lukeweston/LaserCutter/README.markdown

Open-hardware Arduino-compatible (Arduino Mega 2650-compatible) CNC laser cutter

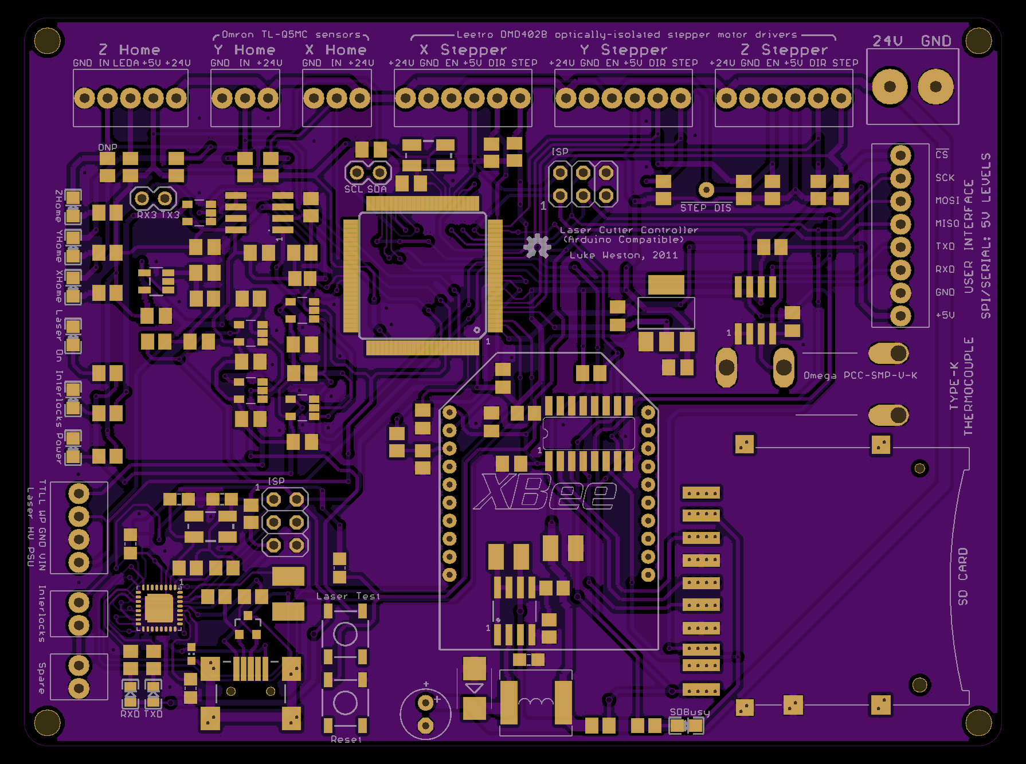
[picture p1: LaserCutter-pcb.png]


Documentation goes here - when it's done.
