lukeweston/LaserCutter/LaserCutter-schematic.png

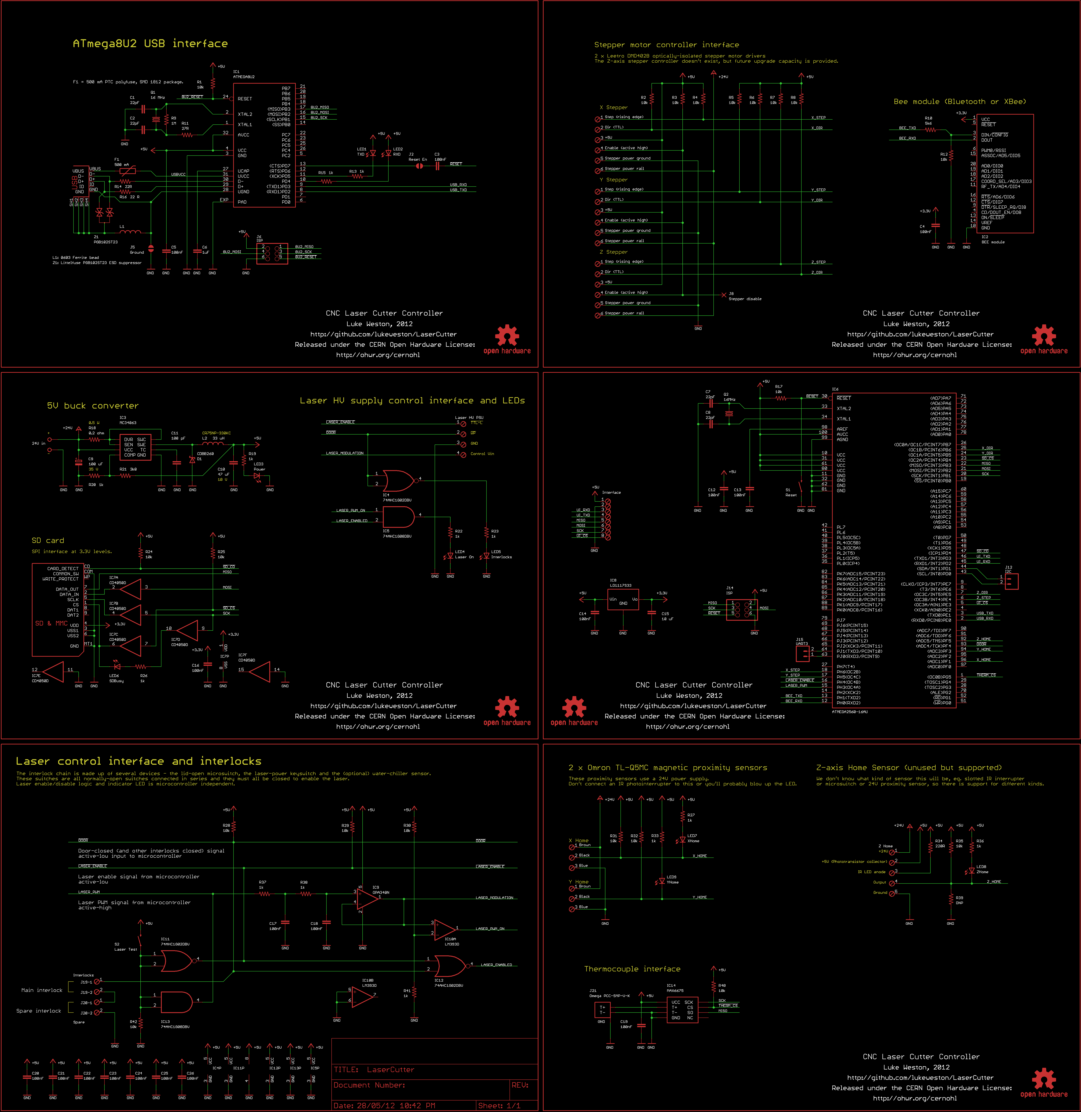
LaserCutter-schematic.png
