lukeweston/LaserCutter/LaserCutter.brd

## EAGLE design LaserCutter.brd (2012-07-18)

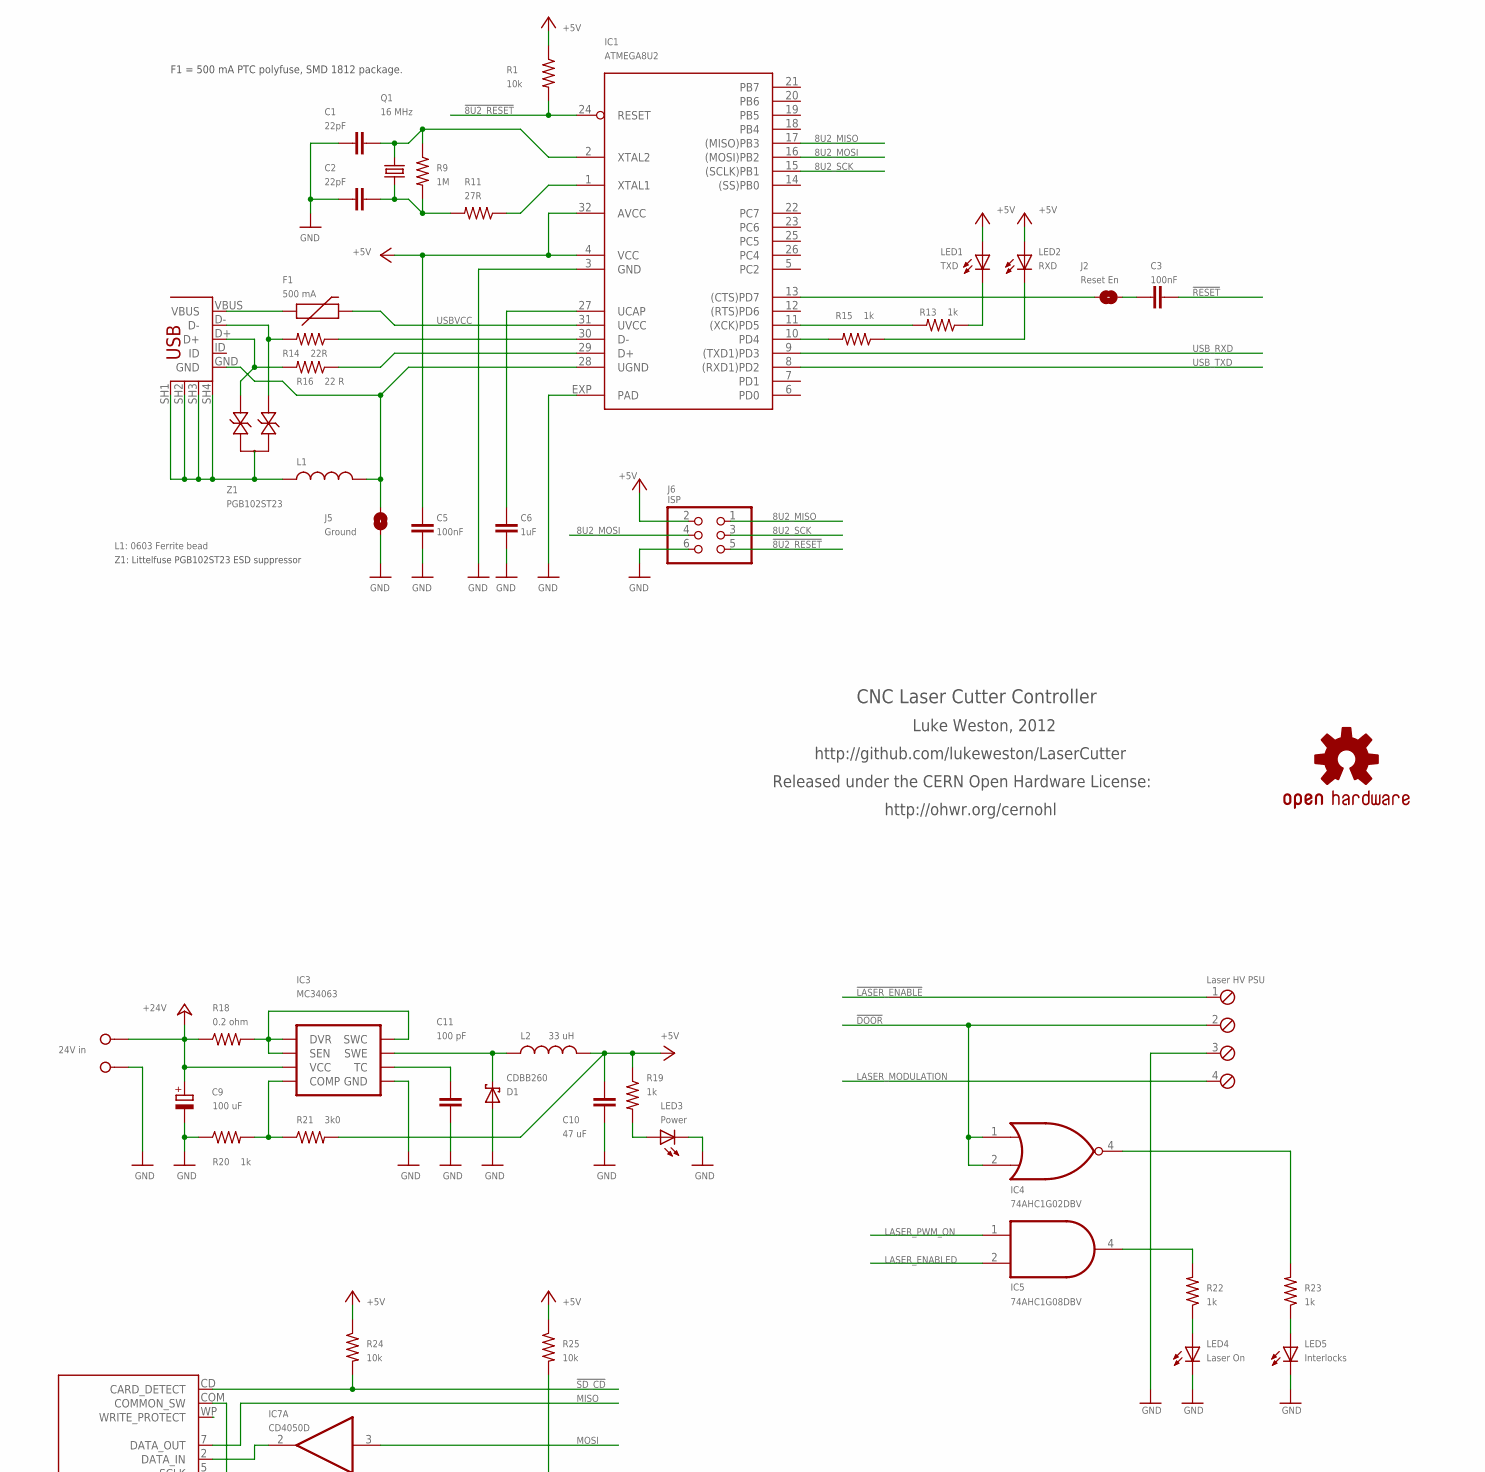
[picture p3: schematic LaserCutter.sch, part in row 1, column 1]

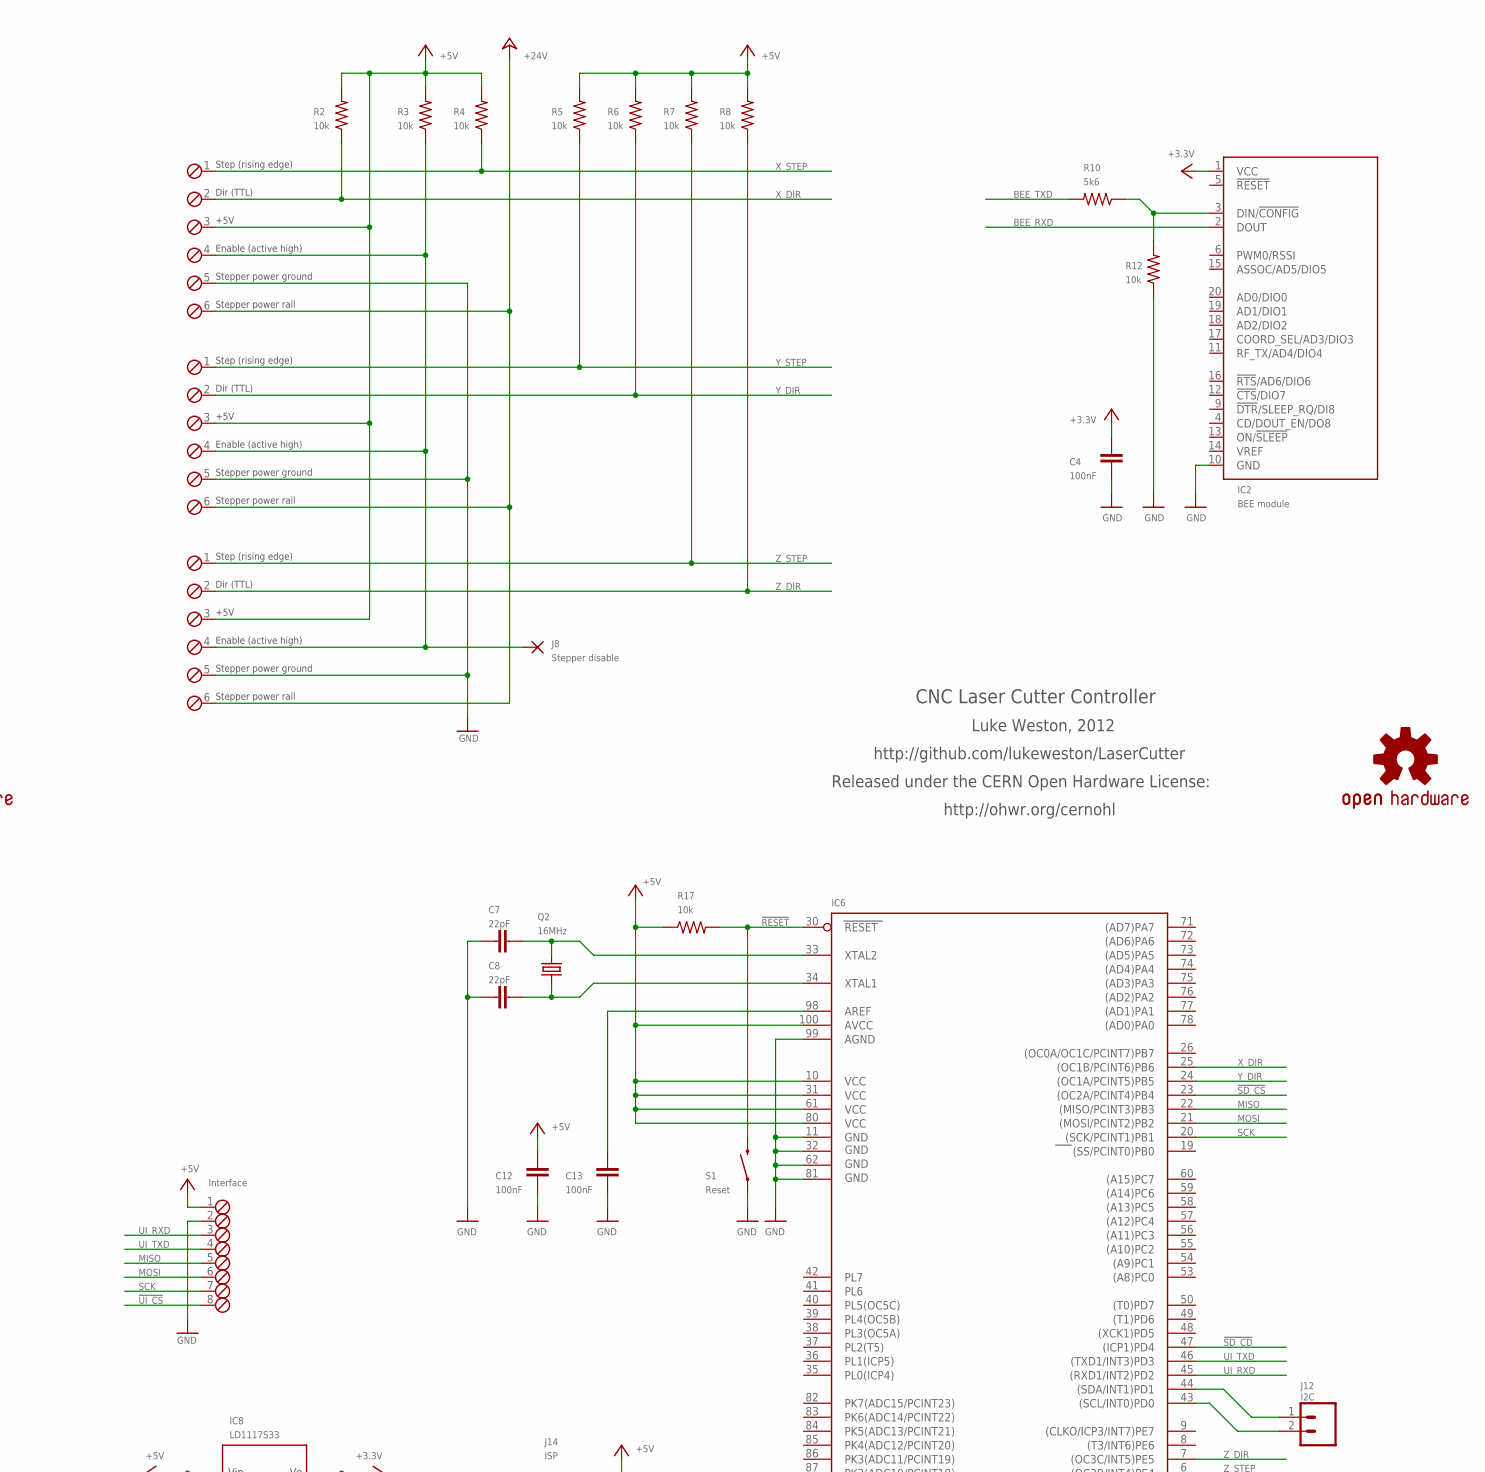
[picture p4: schematic LaserCutter.sch, part in row 1, column 2]

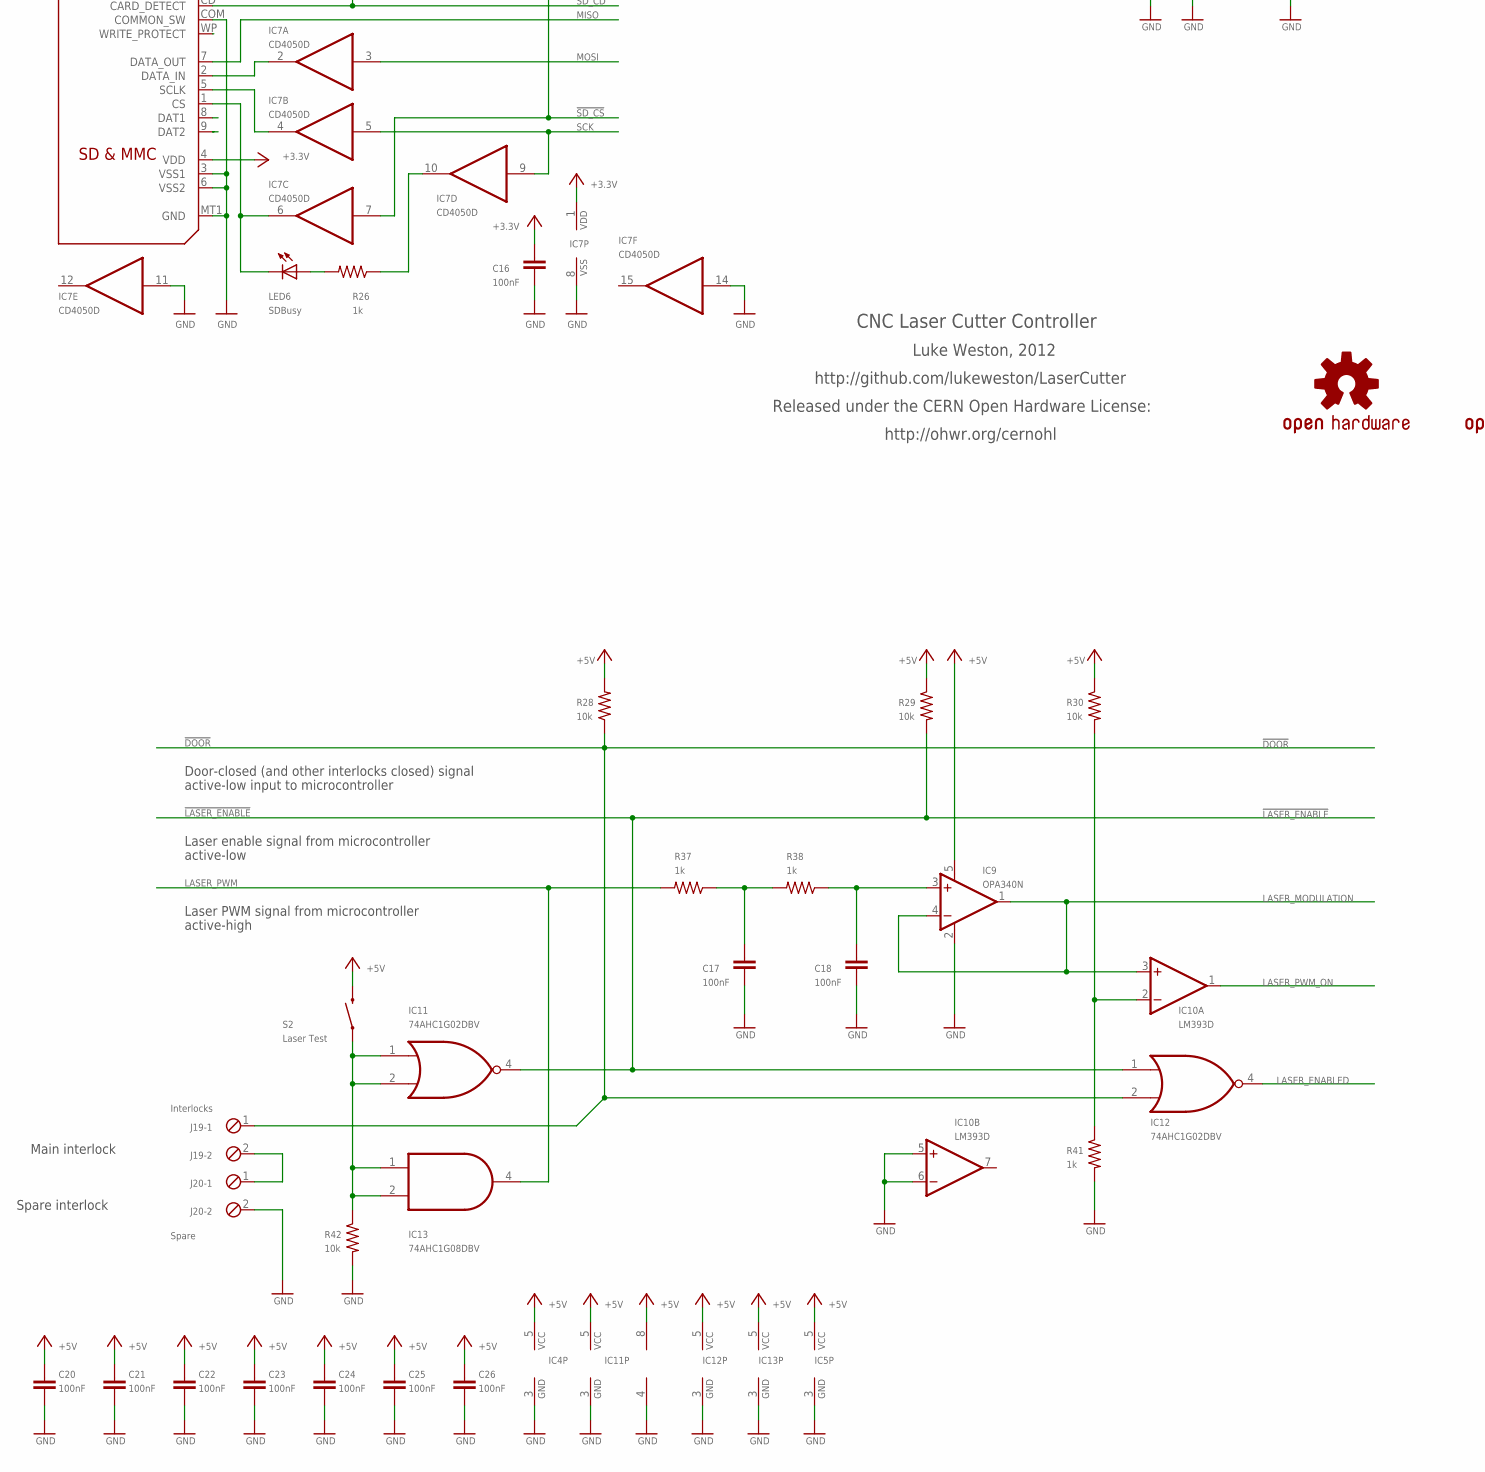
[picture p5: schematic LaserCutter.sch, part in row 2, column 1]

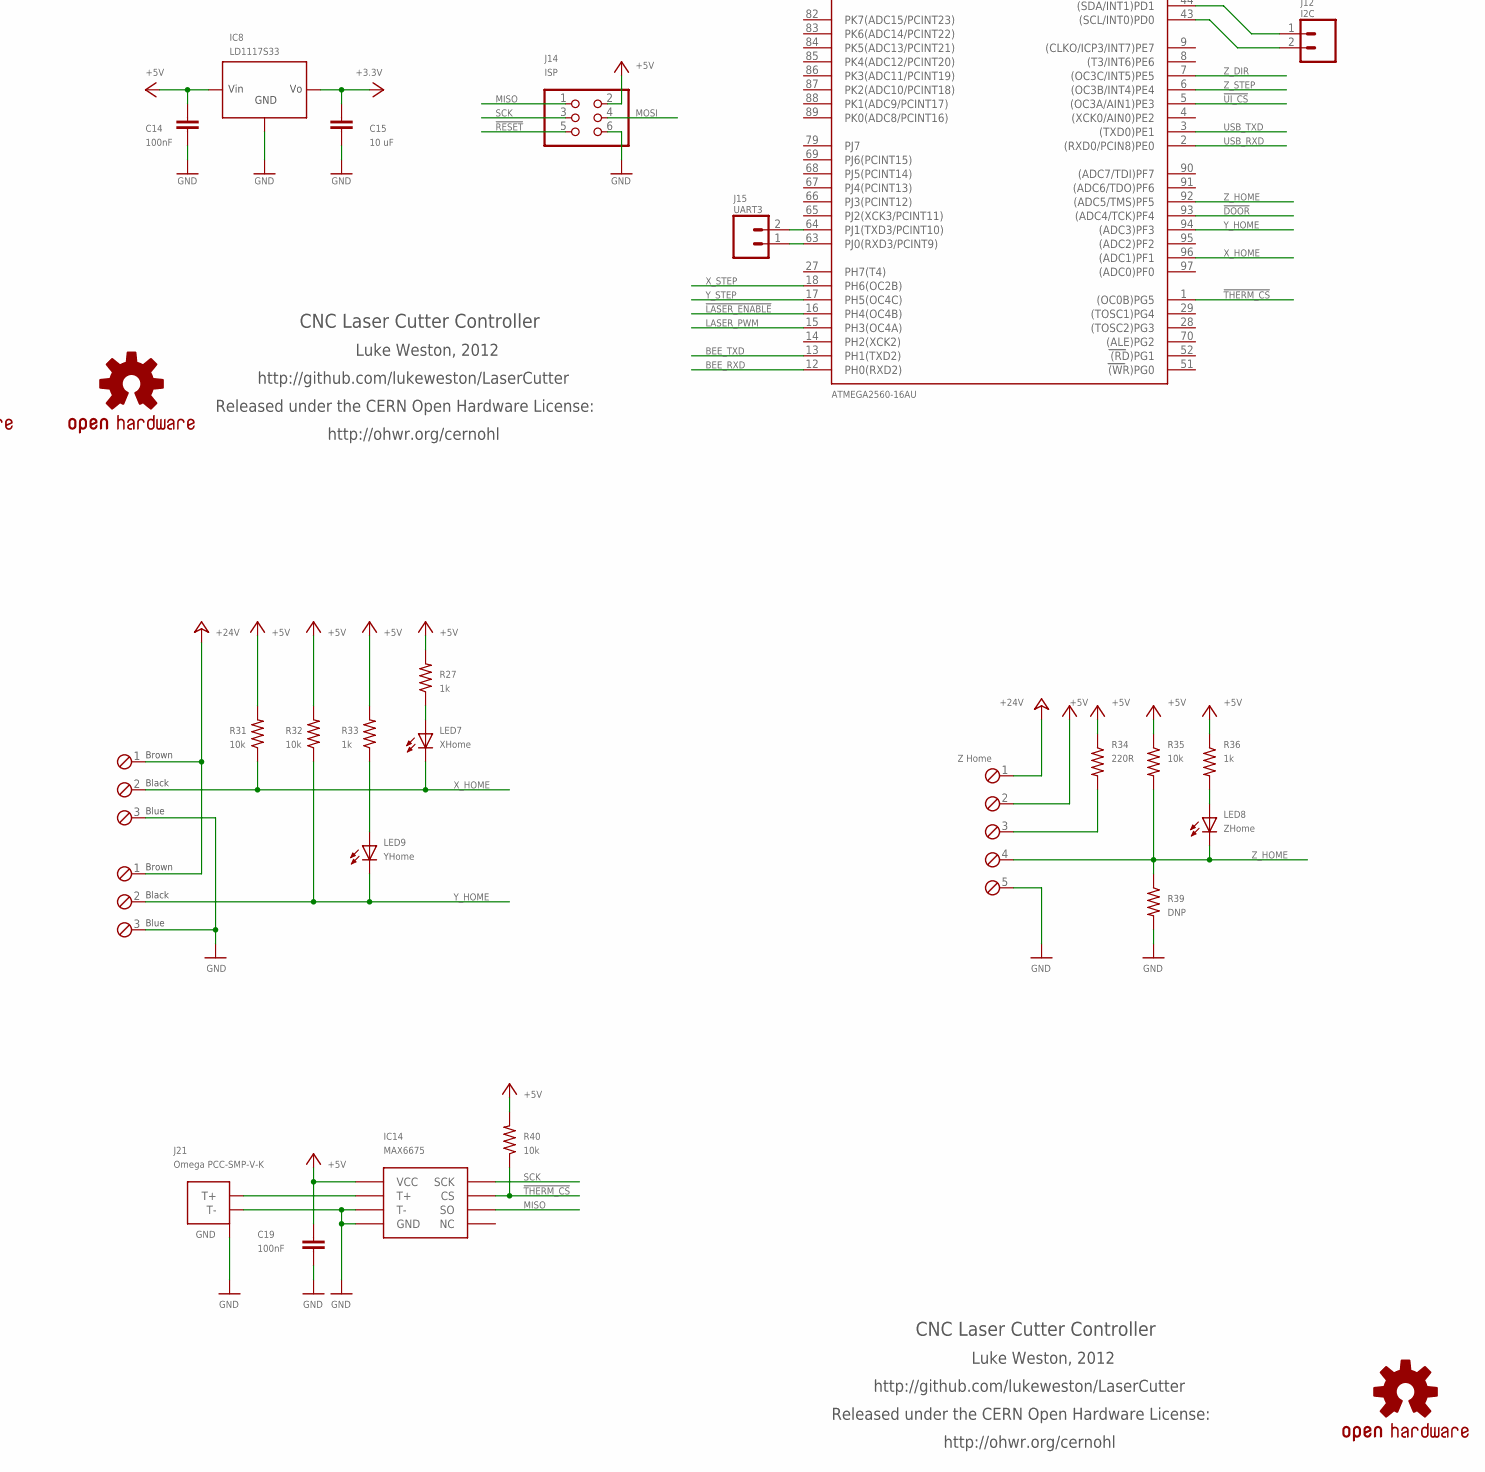
[picture p6: schematic LaserCutter.sch, part in row 2, column 2]

Parts:
$1: OSHW-LOGOS; OSHW-LOGO-S
C1, C2: 22pF; 0805-LARGE
C3, C5: 100nF; 0805-LARGE
C4, C12, C13, C14, C16, C17, C18, C19, C20, C21, C22, C23, C24, C25, C26: 100nF; C0805K
C6: 1uF; 0805-LARGE
C7, C8: 22pF; C0805K
C9: 100 uF; E2,5-6
C10: 47 uF; C1210
C11: 100 pF; 0805-LARGE
C15: 10 uF; C0805K
D1: CDBB260; SMB
F1: 500 mA; 1812
IC1: ATMEGA8U2; ATMEL_QFN32
IC2: BEE module; XBEE-PRO
IC3: MC34063; SO08
IC4, IC11, IC12: 74AHC1G02DBV; SOT23-5
IC5, IC13: 74AHC1G08DBV; SOT23-5
IC6: ATMEGA2560-16AU; TQFP100
IC7: CD4050D; SO16
IC8: LD1117S33; SOT223
IC9: OPA340N; SOT23-5
IC10: LM393D; SO08
IC14: MAX6675; SOIC8-2
J1: X Stepper; 6POL254
J2: Reset En; SJ
J3: USB; USB-MINIB-FT
J4: Y Stepper; 6POL254
J5: Ground; SJ
J6, J14: ISP; 2X03
J7: Z Stepper; 6POL254
J8: Stepper disable; 1,6/0,8
J9: Laser HV PSU; 4POL254
J10: 24V in; W237-132
J11: Interface; 8POL254
J12: I2C; 1X02
J13: SDMMC18650; SDCARD
J15: UART3; 1X02
J16: X Home; 3POL254
J17: Z Home; 5POL254
J18: Y Home; 3POL254
J19: Interlocks; 2POL254
J20: Spare; 2POL254
J21: Omega PCC-SMP-V-K; PCC-SMP-V
L1: L1: 0603 Ferrite bead; 0603
L2: 33 uH; CR75
LED1: TXD; LED-0805
LED2: RXD; LED-0805
LED3: Power; LED-0805-LARGE
LED4: Laser On; LED-0805-LARGE
LED5: Interlocks; LED-0805-LARGE
LED6: SDBusy; LED-0805-LARGE
LED7: XHome; LED-0805-LARGE
LED8: ZHome; LED-0805-LARGE
LED9: YHome; LED-0805-LARGE
Q1: 16 MHz; CRYSTAL-SMD-5X3
Q2: 16MHz; CRYSTAL-SMD-5X3
R1, R17, R28: 10k; R0805
R2, R3, R4, R5, R6, R7, R8, R12, R24, R25, R29, R30, R31, R32, R35, R40, R42: 10k; M0805
R9: 1M; R0805
R10: 5k6; M0805
R11: 27R; R0805
R13, R15, R19, R20, R26: 1k; R0805
R14: 22R; R0805
R16: 22 R; R0805
R18: 0.2 ohm; R1210
R21: 3k0; R0805
R22, R23, R27, R33, R36, R37, R38, R41: 1k; M0805
R34: 220R; M0805
R39: DNP; M0805
S1: Reset; TACTILE_SWITCH_SMD
S2: Laser Test; TACTILE_SWITCH_SMD
U$, U$1, U$2, U$3: OSHW-LOGOS; OSHW-LOGO-S
Z1: PGB102ST23; SOT23-3

Connections:
8U2_MISO: IC1.17 ((MISO)PB3), J6.1
8U2_MOSI: IC1.16 ((MOSI)PB2), J6.4
8U2_SCK: IC1.15 ((SCLK)PB1), J6.3
!8U2_RESET: IC1.24 (RESET), J6.5, R1.2
!DOOR: IC4.1 (I0), IC4.2 (I1), IC6.93 ((ADC4/TCK)PF4), IC12.2 (I1), J9.2, J19.1, R28.1
!LASER_ENABLE: IC6.16 (PH4(OC4B)), IC11.4 (O), IC12.1 (I0), J9.1, R29.2
!RESET: C3.2, IC6.30 (RESET), J14.5, R17.2, S1.3 (2)
!SD_CD: IC6.47 ((ICP1)PD4), J13.CD (CARD_DETECT), R24.2
!SD_CS: IC6.23 ((OC2A/PCINT4)PB4), IC7.7 (I), R25.2
!THERM_CS: IC6.1 ((OC0B)PG5), IC14.6 (CS), R40.1
!UI_CS: IC6.5 ((OC3A/AIN1)PE3), J11.8
+3V3: C4.1, C15.1, C16.1, IC2.1 (VCC), IC7.1 (VDD), IC8.2 (VOUT), J13.4 (VDD)
+5V: C5.1, C10.1, C12.2, C14.1, C19.1, C20.1, C21.1, C22.1, C23.1, C24.1, C25.1, C26.1, IC1.4 (VCC), IC1.32 (AVCC), IC4.5 (VCC), IC5.5 (VCC), IC6.10 (VCC), IC6.31 (VCC1), IC6.61 (VCC2), IC6.80 (VCC3), IC6.100 (AVCC), IC8.3 (VIN), IC9.5 (V+), IC10.8 (V+), IC11.5 (VCC), IC12.5 (VCC), IC13.5 (VCC), IC14.4 (VCC), J1.3, J4.3, J6.2, J7.3, J11.1, J14.2, J17.2, L2.P$2 (2), LED1.A, LED2.A, R1.1, R2.2, R3.2, R4.2, R5.2, R6.2, R7.2, R8.2, R17.1, R19.1, R21.2, R24.1, R25.1, R27.2, R28.2, R29.1, R30.1, R31.2, R32.2, R33.2, R34.1, R35.1, R36.1, R40.2, S2.3 (2)
+24V: C9.+, IC3.6 (VCC), J1.6, J4.6, J7.6, J10.1, J16.1, J17.1, J18.1, R18.1
BEE_RXD: IC2.2 (DOUT), IC6.12 (PH0(RXD2))
BEE_TXD: IC6.13 (PH1(TXD2)), R10.2
DAT1: J13.8 (DAT1)
DAT2: J13.9 (DAT2)
GND: C1.1, C2.1, C4.2, C5.2, C6.2, C7.1, C8.1, C9.-, C10.2, C11.2, C12.1, C13.1, C14.2, C15.2, C16.2, C17.2, C18.2, C19.2, C20.2, C21.2, C22.2, C23.2, C24.2, C25.2, C26.2, D1.A, IC1.3 (GND), IC1.EXP (PAD), IC2.10 (GND), IC3.4 (GND), IC4.3 (GND), IC5.3 (GND), IC6.11 (GND), IC6.32 (GND1), IC6.62 (GND2), IC6.81 (GND3), IC6.99 (AGND), IC7.8 (VSS), IC7.11 (I), IC7.14 (I), IC8.1 (GND), IC9.2 (V-), IC10.4 (V-), IC10.5 (+IN), IC10.6 (-IN), IC11.3 (GND), IC12.3 (GND), IC13.3 (GND), IC14.1 (GND), IC14.2 (T-), J1.5, J4.5, J5.2, J6.6, J7.5, J9.3, J10.2, J11.2, J13.3 (VSS1), J13.6 (VSS2), J13.COM (COMMON_SW), J13.MT1 (GND), J14.6, J16.3, J17.5, J18.3, J20.2, J21.P$1 (GND), J21.P$2 (GND), J21.T-, LED3.C, LED4.C, LED5.C, R12.1, R20.1, R39.2, R41.2, R42.2, S1.1
J81: J1.4, J4.4, J7.4, J8.1, R3.1
LASER_ENABLED: IC5.2 (I1), IC12.4 (O)
LASER_MODULATION: IC9.1 (OUT), IC9.4 (-IN), IC10.3 (+IN), J9.4
LASER_PWM: IC6.15 (PH3(OC4A)), IC13.4 (O), R37.2
LASER_PWM_ON: IC5.1 (I0), IC10.1 (OUT)
MISO: IC6.22 ((MISO/PCINT3)PB3), IC14.7 (SO), J11.5, J13.7 (DATA_OUT), J14.1
MOSI: IC6.21 ((MOSI/PCINT2)PB2), IC7.3 (I), J11.6, J14.4
unnamed: IC7.2 (O), J13.2 (DATA_IN)
unnamed: LED3.A, R19.2
unnamed: C7.2, IC6.33 (XTAL2), Q2.3 (2)
unnamed: IC2.3 (DIN/!CONFIG), R10.1, R12.2
unnamed: IC1.28 (UGND), J3.GND, J5.1, L1.2
unnamed: IC11.1 (I0), IC11.2 (I1), IC13.1 (I0), IC13.2 (I1), R42.1, S2.1
unnamed: IC3.1 (SWC), IC3.7 (SEN), IC3.8 (DVR), R18.2
unnamed: IC7.4 (O), J13.5 (SCLK)
unnamed: LED6.A, R26.2
unnamed: C11.1, IC3.3 (TC)
unnamed: J19.2, J20.1
unnamed: IC3.5 (COMP), R20.2, R21.1
unnamed: LED8.A, R36.2
unnamed: IC10.2 (-IN), R30.2, R41.1
unnamed: IC7.10 (O), R26.1
unnamed: IC7.6 (O), J13.1 (CS), LED6.C
unnamed: D1.C, IC3.2 (SWE), L2.P$1 (1)
unnamed: IC5.4 (O), R22.2
unnamed: LED4.A, R22.1
unnamed: C18.1, IC9.3 (+IN), R38.1
unnamed: IC14.3 (T+), J21.T+
unnamed: C17.1, R37.1, R38.2
unnamed: IC4.4 (O), R23.2
unnamed: LED9.A, R33.1
unnamed: LED5.A, R23.1
unnamed: LED7.A, R27.1
unnamed: J17.3, R34.2
unnamed: C8.2, IC6.34 (XTAL1), Q2.1
unnamed: C13.2, IC6.98 (AREF)
unnamed: C1.2, IC1.2 (XTAL2), Q1.3 (2), R9.1
unnamed: IC1.1 (XTAL1), R11.1
unnamed: C2.2, Q1.1, R9.2, R11.2
unnamed: F1.1, J3.VBUS
unnamed: J3.D+, R16.2, Z1.2
unnamed: C6.1, IC1.27 (UCAP)
unnamed: J3.D-, R14.2, Z1.1
unnamed: IC1.30 (D-), R14.1
unnamed: IC1.29 (D+), R16.1
unnamed: LED2.C, R15.1
unnamed: C3.1, J2.2
unnamed: IC1.13 ((CTS)PD7), J2.1
unnamed: IC1.11 ((XCK)PD5), R13.2
unnamed: IC1.10 (PD4), R15.2
unnamed: LED1.C, R13.1
unnamed: J3.SH1 (SH$1), J3.SH2 (SH$2), J3.SH3 (SH$3), J3.SH4 (SH$4), L1.1, Z1.3
RXD3: IC6.63 (PJ0(RXD3/PCINT9)), J15.1
SCK: IC6.20 ((SCK/PCINT1)PB1), IC7.5 (I), IC7.9 (I), IC14.5 (SCK), J11.7, J14.3
SCL: IC6.43 ((SCL/INT0)PD0), J12.2
SDA: IC6.44 ((SDA/INT1)PD1), J12.1
TXD3: IC6.64 (PJ1(TXD3/PCINT10)), J15.2
UI_RXD: IC6.45 ((RXD1/INT2)PD2), J11.3
UI_TXD: IC6.46 ((TXD1/INT3)PD3), J11.4
USBVCC: F1.2, IC1.31 (UVCC)
USB_RXD: IC1.9 ((TXD1)PD3), IC6.2 ((RXD0/PCIN8)PE0)
USB_TXD: IC1.8 ((RXD1)PD2), IC6.3 ((TXD0)PE1)
WP: J13.WP (WRITE_PROTECT)
X_DIR: IC6.25 ((OC1B/PCINT6)PB6), J1.2, R2.1
X_HOME: IC6.96 ((ADC1)PF1), J16.2, LED7.C, R31.1
X_STEP: IC6.18 (PH6(OC2B)), J1.1, R4.1
Y_DIR: IC6.24 ((OC1A/PCINT5)PB5), J4.2, R6.1
Y_HOME: IC6.94 ((ADC3)PF3), J18.2, LED9.C, R32.1
Y_STEP: IC6.17 (PH5(OC4C)), J4.1, R5.1
Z_DIR: IC6.7 ((OC3C/INT5)PE5), J7.2, R8.1
Z_HOME: IC6.92 ((ADC5/TMS)PF5), J17.4, LED8.C, R35.2, R39.1
Z_STEP: IC6.6 ((OC3B/INT4)PE4), J7.1, R7.1

Notes on the sheet:
Z1: Littelfuse PGB102ST23 ESD suppressor
F1 = 500 mA PTC polyfuse, SMD 1812 package.
Step (rising edge)
Dir (TTL)
+5V
Enable (active high)
Stepper power ground
Stepper power rail
Brown
Black
Blue
Main interlock
Spare interlock
Laser PWM signal from microcontroller
active-high
Laser enable signal from microcontroller
active-low
Door-closed (and other interlocks closed) signal
active-low input to microcontroller
CNC Laser Cutter Controller
Luke Weston, 2012
http://github.com/lukeweston/LaserCutter
Released under the CERN Open Hardware License:
http://ohwr.org/cernohl

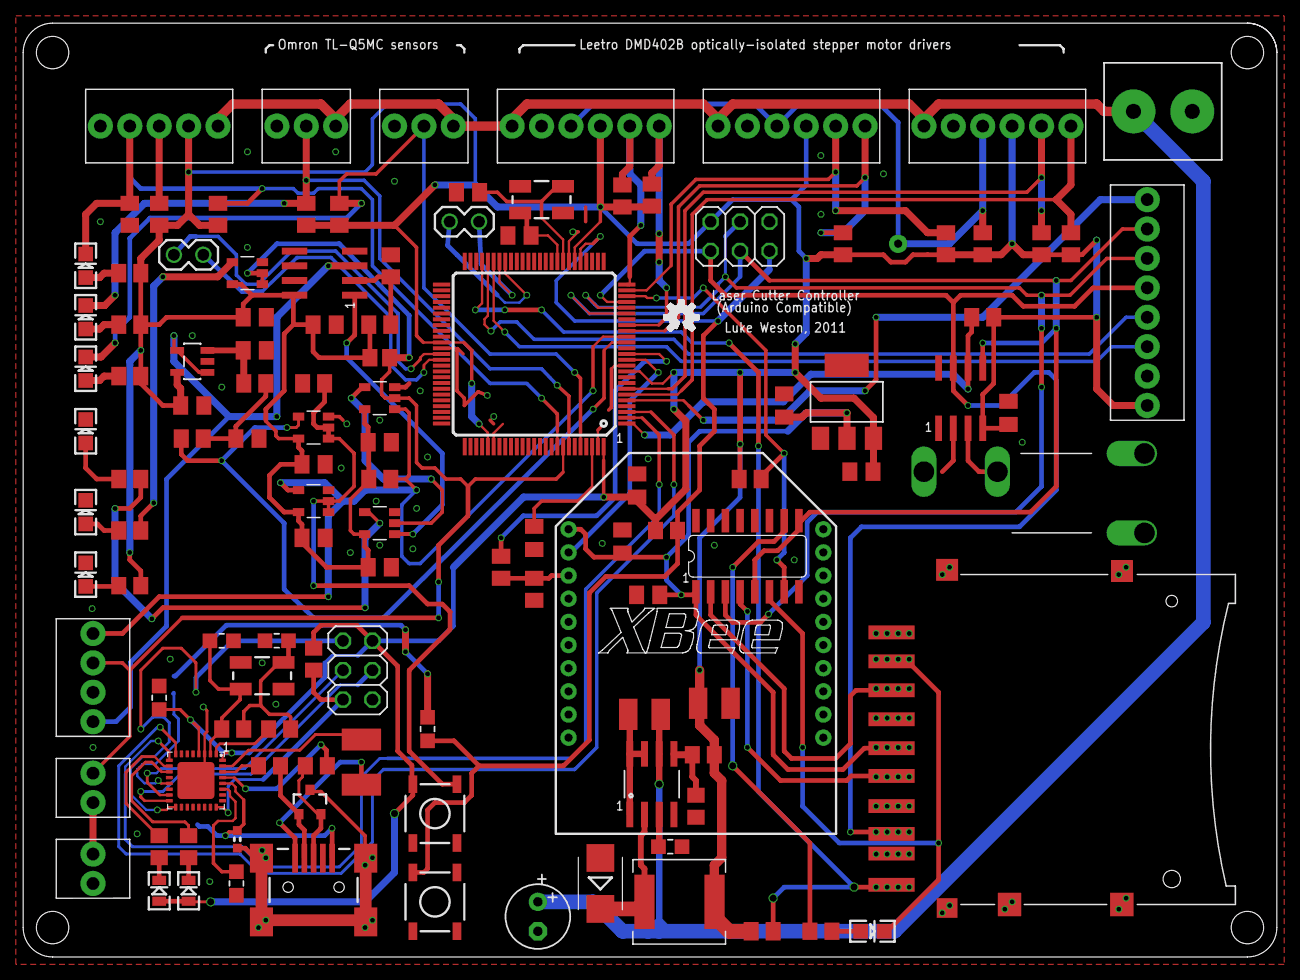
[picture p7: board LaserCutter.brd from above]

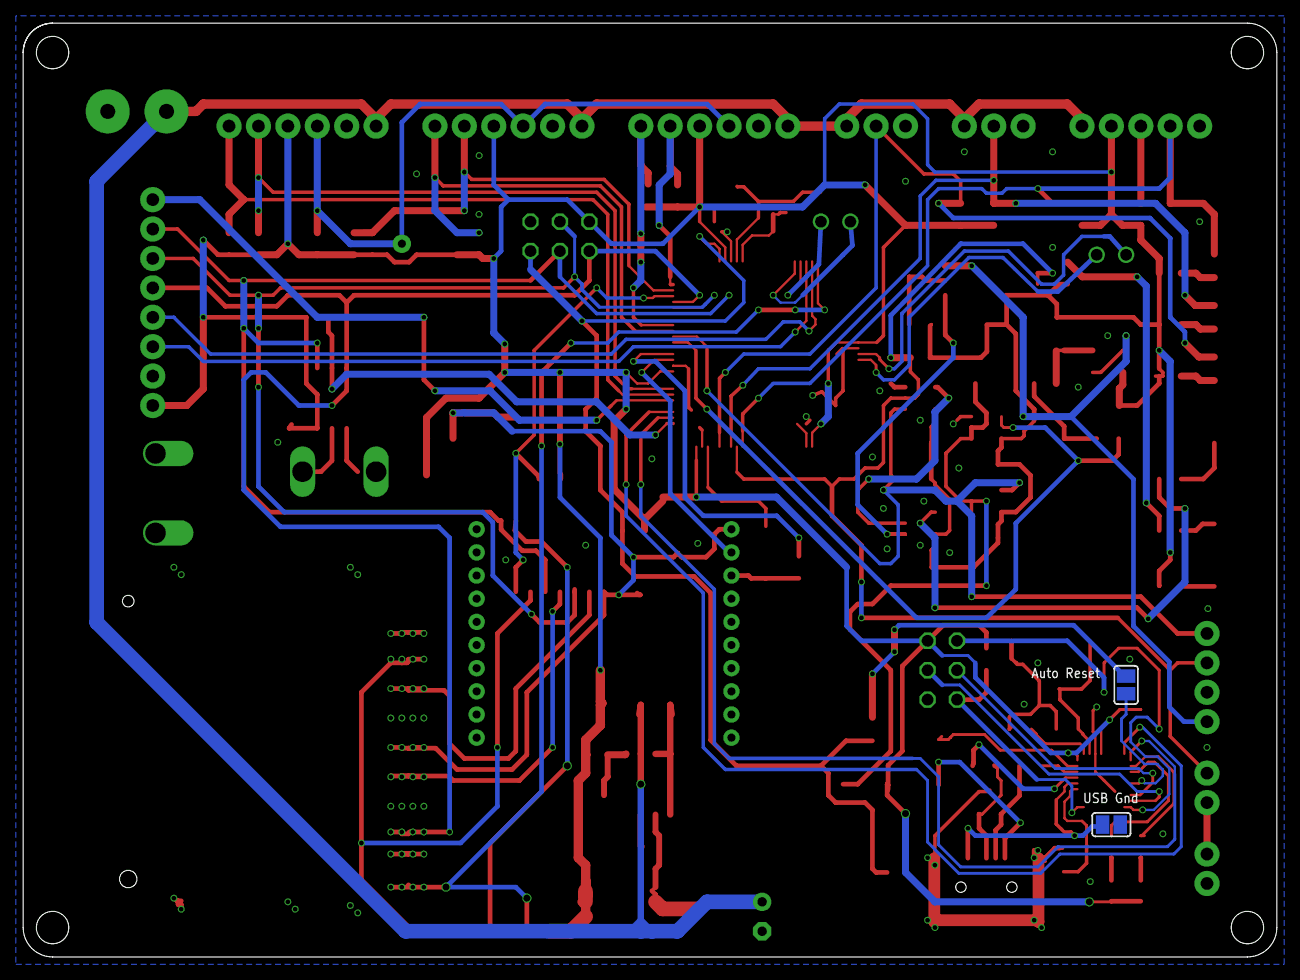
[picture p8: board LaserCutter.brd from below]

Board: 2 copper layers, 108.3 x 80.6 mm, 126 parts (2 on the bottom side), 88 nets.
