lukeweston/LaserCutter/(commit log)

2012-04-05 reworked SPI interface
    [LaserCutter.brd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]
2012-05-03 changed to cheaper MC34063 buck converter
    [LaserCutter-documentation.sch, LaserCutter.brd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]
2012-05-13 fixed terminal block PCB footprints
    [LaserCutter.brd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]
2012-07-18 a few tweaks
    [LaserCutter.brd, LaserCutter.sch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]
